kenbiba/ARLISSLite/24 2020 29mm Rocket/29mm S4 Kit Recovery.stl

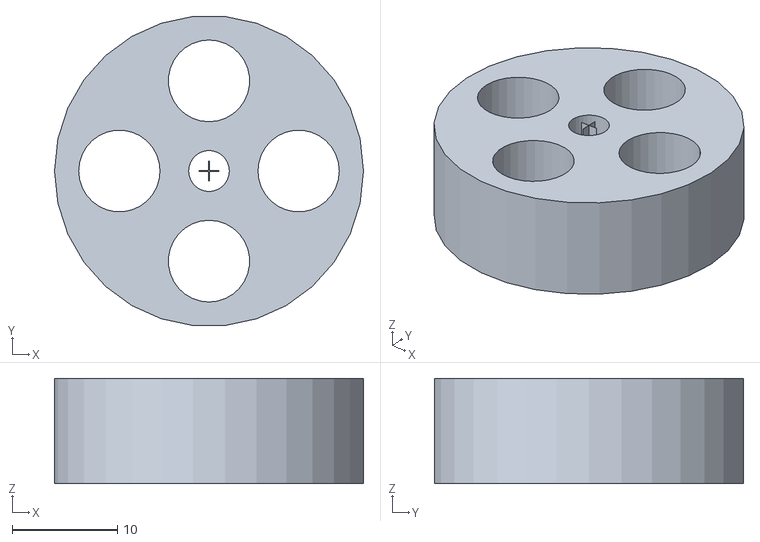
[picture p8: CAD file, 2020-05-25]
24 2020 29mm Rocket/29mm S4 Kit Recovery.stl
29.4 x 29.4 x 10.0
