kenbiba/ARLISSLite/S4 2020 24mm Rocket/24mm S4 Kit Retainer 1.stl

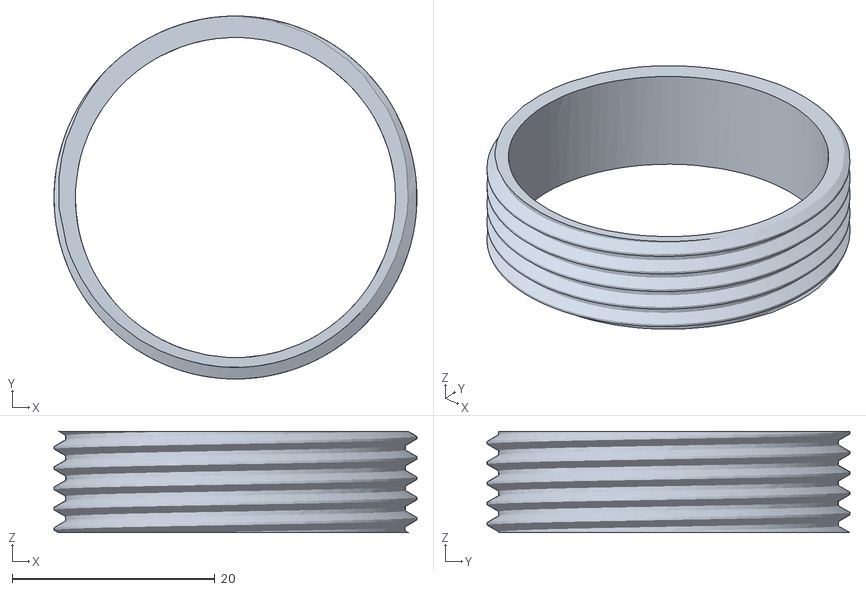
[picture p9: CAD file, 2020-05-25]
S4 2020 24mm Rocket/24mm S4 Kit Retainer 1.stl
35.8 x 35.8 x 10.00
