kenbiba/ARLISSLite/S4 2020 54mm Rocket/54mm S4 Airframe-2.stl

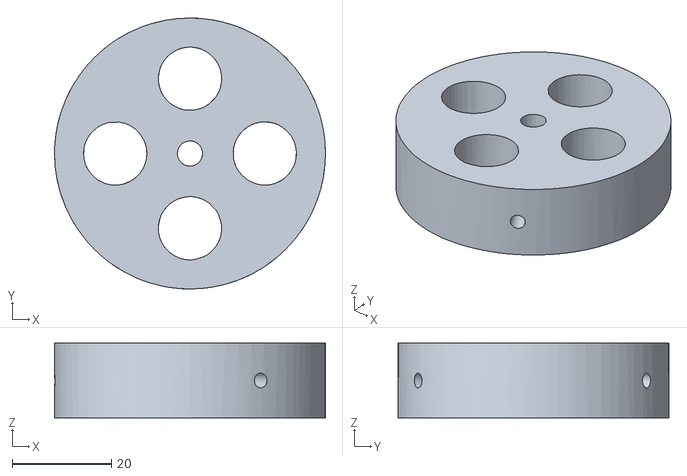
[picture p10: CAD file, 2020-07-29]
S4 2020 54mm Rocket/54mm S4 Airframe-2.stl
54.5 x 54.5 x 15.0
