kenbiba/ARLISSLite/S4 2020 Payload Nosecone/S4 Nosecone Bottom.stl

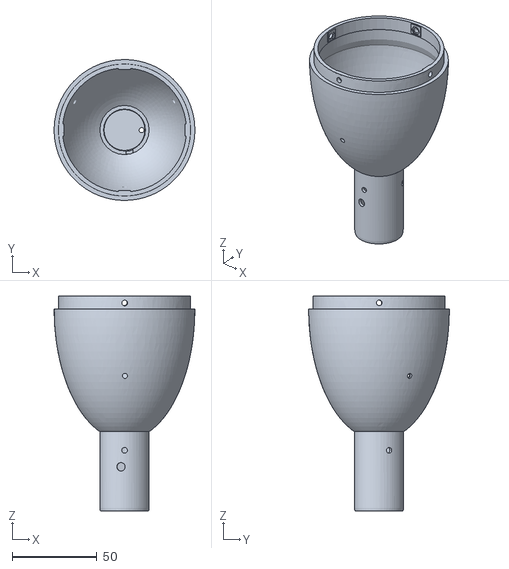
[picture p11: CAD file, 2020-05-25]
S4 2020 Payload Nosecone/S4 Nosecone Bottom.stl
82.8 x 82.8 x 126.5
