kenbiba/ARLISSLite/24 2020 29mm Rocket/29mm S4 Kit Rail-1.stl

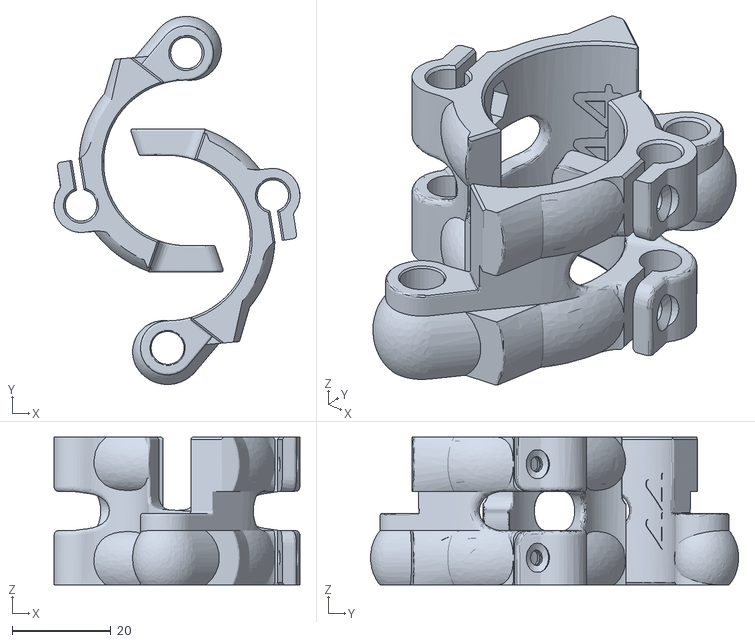
[picture p12: CAD file, 2020-05-25]
24 2020 29mm Rocket/29mm S4 Kit Rail-1.stl
49.9 x 74.7 x 30.0
