kenbiba/ARLISSLite/S4 2020 24mm Rocket/24mm S4 Kit Rail 2.stl

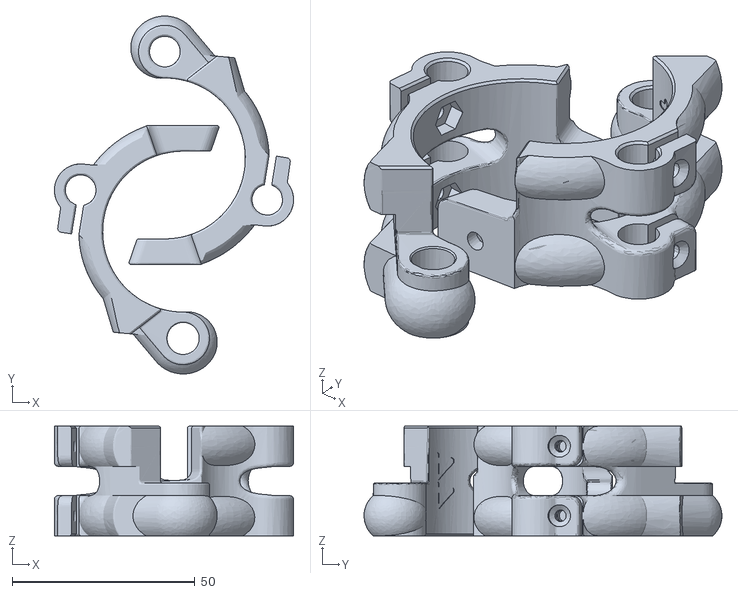
[picture p13: CAD file, 2020-05-25]
S4 2020 24mm Rocket/24mm S4 Kit Rail 2.stl
65.4 x 97.9 x 30.0
