kenbiba/ARLISSLite/S4 2020 54mm Rocket/S4 ARLISS Lite Nosecone-6.stl

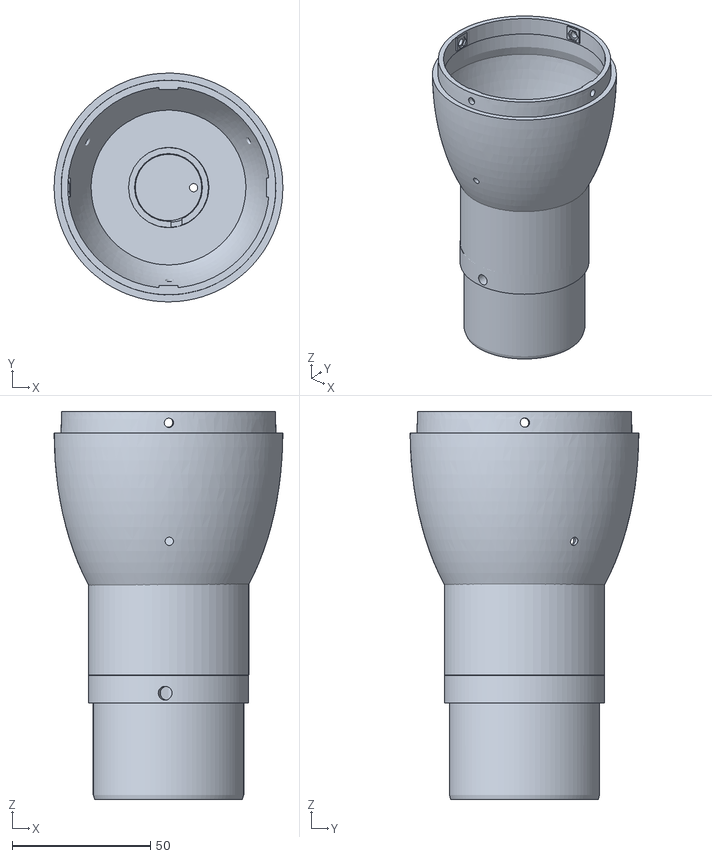
[picture p14: CAD file, 2020-07-29]
S4 2020 54mm Rocket/S4 ARLISS Lite Nosecone-6.stl
82.8 x 82.8 x 140.5
