kenbiba/ARLISSLite/S4 2020 Payload Nosecone/S4 Nosecone Top.stl

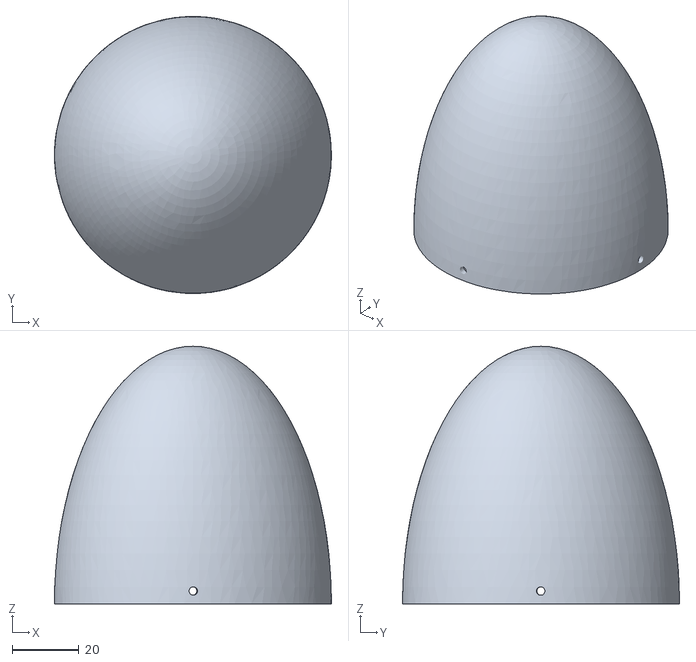
[picture p15: CAD file, 2020-05-25]
S4 2020 Payload Nosecone/S4 Nosecone Top.stl
82.8 x 82.8 x 77.0
