kenbiba/ARLISSLite/24 2020 29mm Rocket/29mm S4 Kit Retainer 2stl.stl

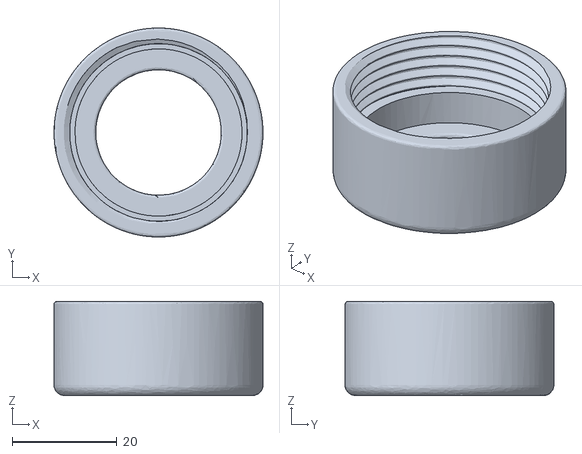
[picture p16: CAD file, 2020-05-25]
24 2020 29mm Rocket/29mm S4 Kit Retainer 2stl.stl
40.0 x 40.0 x 18.0
