kenbiba/ARLISSLite/S4 2020 54mm Rocket/54mm S4 Airframe.stl

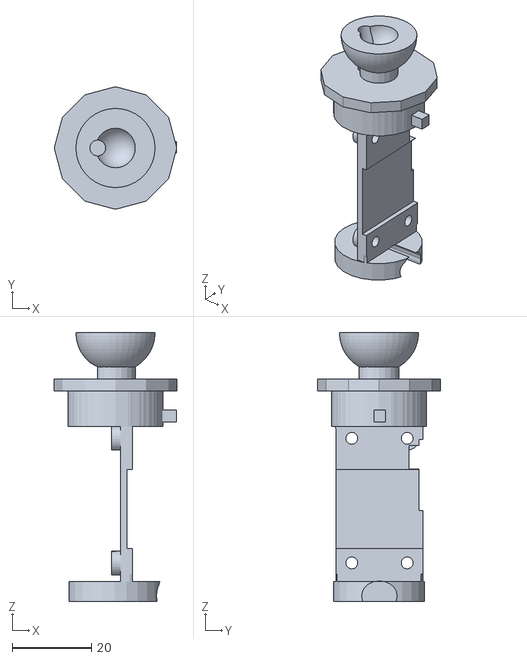
[picture p17: CAD file, 2020-07-29]
S4 2020 54mm Rocket/54mm S4 Airframe.stl
31.0 x 31.0 x 68.0
