kenbiba/ARLISSLite/S4 2020 Payload Nosecone/S4 Nosecone Avionics Bay.stl

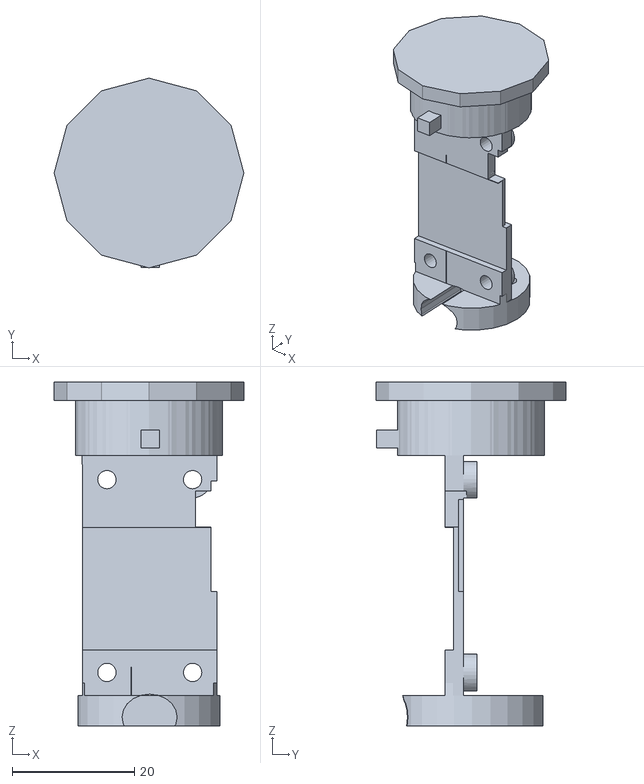
[picture p18: CAD file, 2020-05-25]
S4 2020 Payload Nosecone/S4 Nosecone Avionics Bay.stl
31.0 x 31.0 x 56.2
