kenbiba/ARLISSLite/S4 2020 24mm Rocket/24mm S4 Kit Recovery.stl

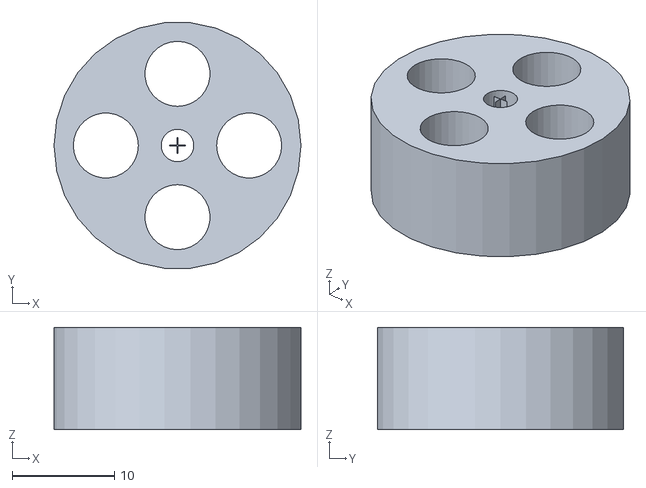
[picture p19: CAD file, 2020-05-25]
S4 2020 24mm Rocket/24mm S4 Kit Recovery.stl
24.1 x 24.0 x 10.0
