kenbiba/ARLISSLite/24 2020 29mm Rocket/29mm S4 Kit Fin Can.stl

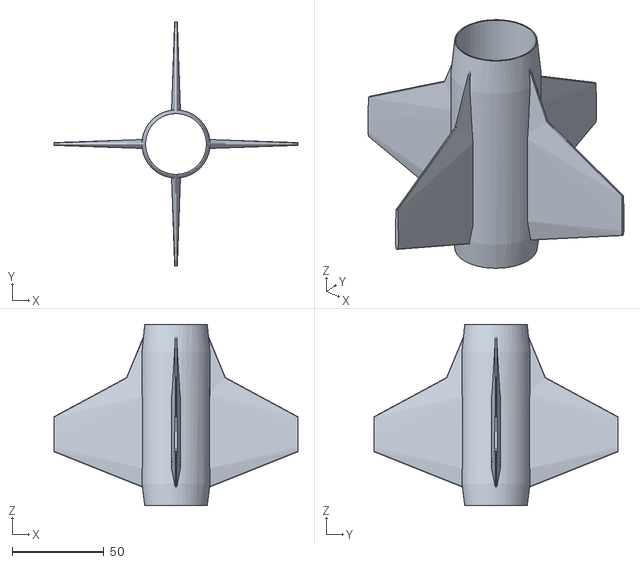
[picture p20: CAD file, 2020-05-25]
24 2020 29mm Rocket/29mm S4 Kit Fin Can.stl
133.2 x 133.2 x 99.0
