kenbiba/ARLISSLite/S4 2020 24mm Rocket/24mm S4 Kit. Fin Can.stl

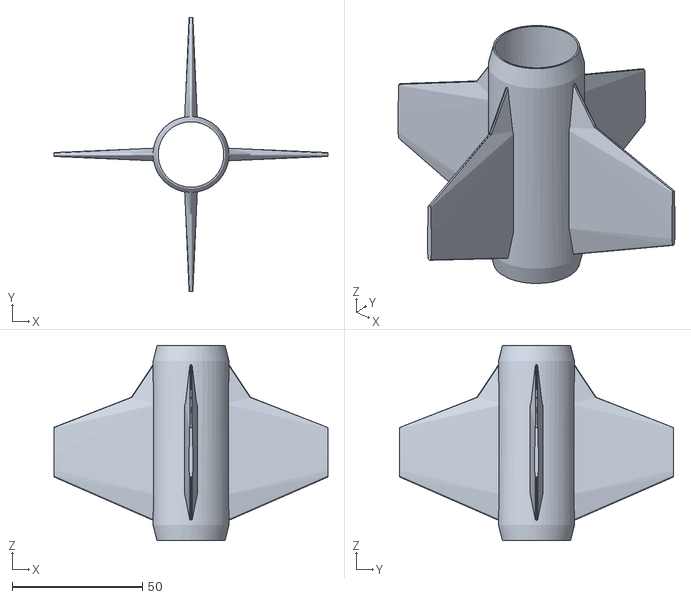
[picture p22: CAD file, 2020-05-25]
S4 2020 24mm Rocket/24mm S4 Kit. Fin Can.stl
105.1 x 105.1 x 75.0
