kenbiba/ARLISSLite/S4 2020 54mm Rocket/54mm S4 Airframe-3.stl

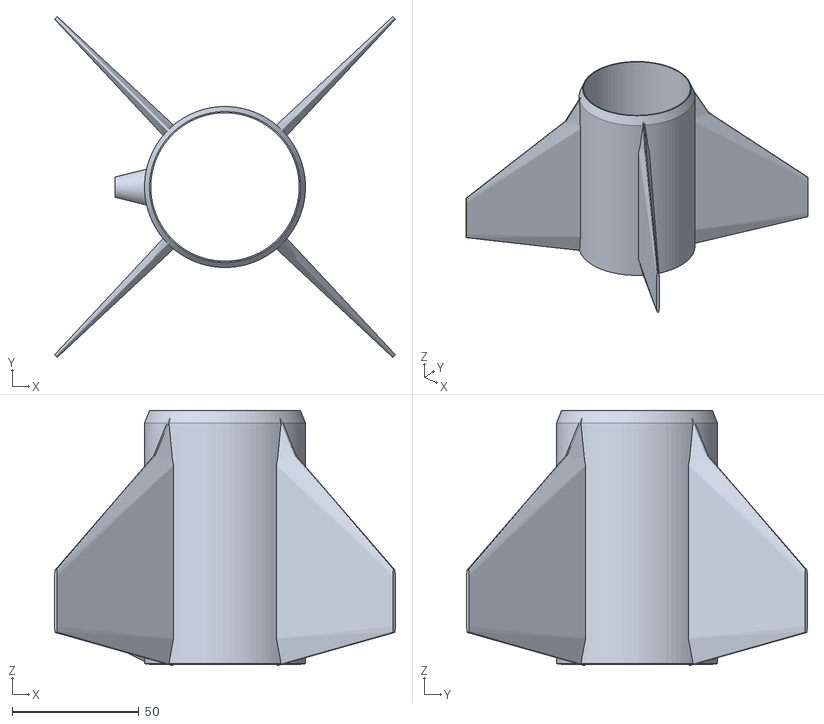
[picture p23: CAD file, 2020-07-29]
S4 2020 54mm Rocket/54mm S4 Airframe-3.stl
134.3 x 134.3 x 100.5
