kenbiba/ARLISSLite/S4 2020 54mm Rocket/S4 ARLISS Lite Nosecone-7.stl

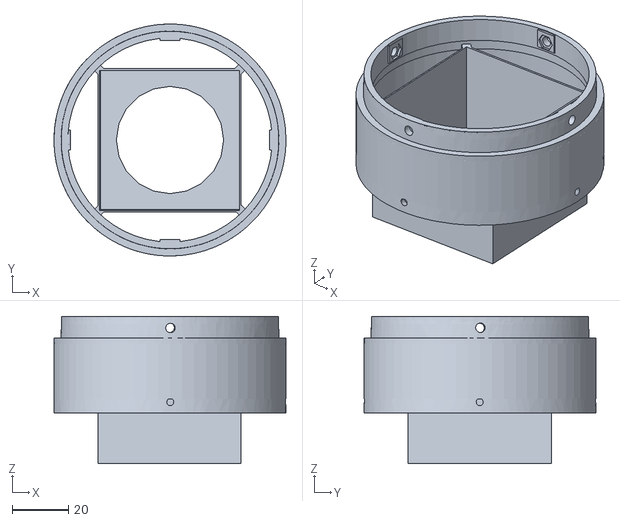
[picture p24: CAD file, 2020-07-29]
S4 2020 54mm Rocket/S4 ARLISS Lite Nosecone-7.stl
82.8 x 82.8 x 52.5
