kenbiba/ARLISSLite/S4 2020 54mm Rocket/54mm S4 Airframe-4.stl

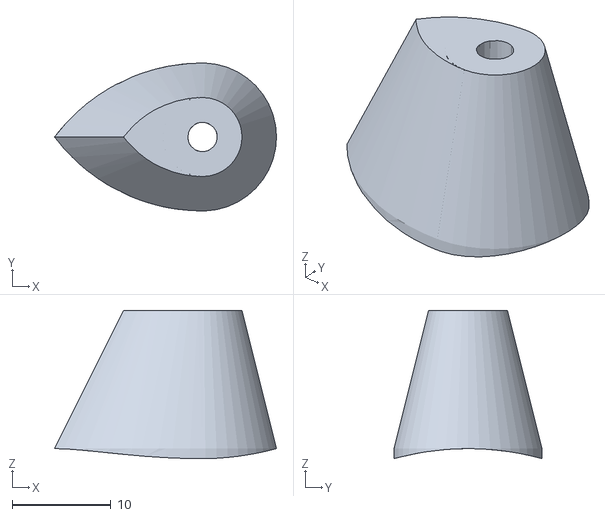
[picture p25: CAD file, 2020-07-29]
S4 2020 54mm Rocket/54mm S4 Airframe-4.stl
22.5 x 15.0 x 15.0
