kenbiba/ARLISSLite/(list of files, cad)

Other CAD files:
S4 2020 24mm Rocket/24mm S4 Kit Rail 1.stl
24 2020 29mm Rocket/29mm S4 Kit Rail-2.stl
S4 2020 54mm Rocket/S4 ARLISS Lite Nosecone-5.stl
S4 2020 24mm Rocket/24mm S4 Kit Retainer 2.stl
24 2020 29mm Rocket/29mm S4 Kit Retainer 1.stl
