kenbiba/ARLISSLite/(commit log)

2020-05-25 Baseline upload
    This hase the basic designs for the ARLISS Lite 24 and 29mm airframes designed to launch a 1P payload
    [24mm S4 Kit Rail 1.stl, 24mm S4 Kit Rail 2.stl, 24mm S4 Kit Recovery.stl, 24mm S4 Kit Retainer 1.stl, 24mm S4 Kit Retainer 2.stl, 24mm S4 Kit. Fin Can.stl, 29mm S4 Kit Fin Can.stl, 29mm S4 Kit Rail-1.stl]
2020-07-29 New updates
    New updates
    [54mm S4 Airframe-2.stl, 54mm S4 Airframe-3.stl, 54mm S4 Airframe-4.stl, 54mm S4 Airframe.stl, S4 ARLISS Lite Nosecone-5.stl, S4 ARLISS Lite Nosecone-6.stl, S4 ARLISS Lite Nosecone-7.stl, S4 ARLISS Lite Nosecone-8.stl]
